mukuchin/SympleEncoderBoard/README.md

SympleEncoderBoard

エンコーダー用基板

神山先輩の回路をEagleで改良したもの

### dipスイッチについて

- 1～6番はエンコーダの回転向きの定義を切り替えるために使う。1～4番はエンコーダの1～4番の向きが切り替わる。5はX,6はY。

- 7は速度を出力するのか、積分したあとの位置を出力するかを切り替える。

- 8は2枚目のボードをつないだときに識別できるようにボード番号を切り替えるためのもの。
