mukuchin/SympleEncoderBoard/SympleEncoderBoard.brd

## EAGLE design SympleEncoderBoard.brd (2021-01-08)

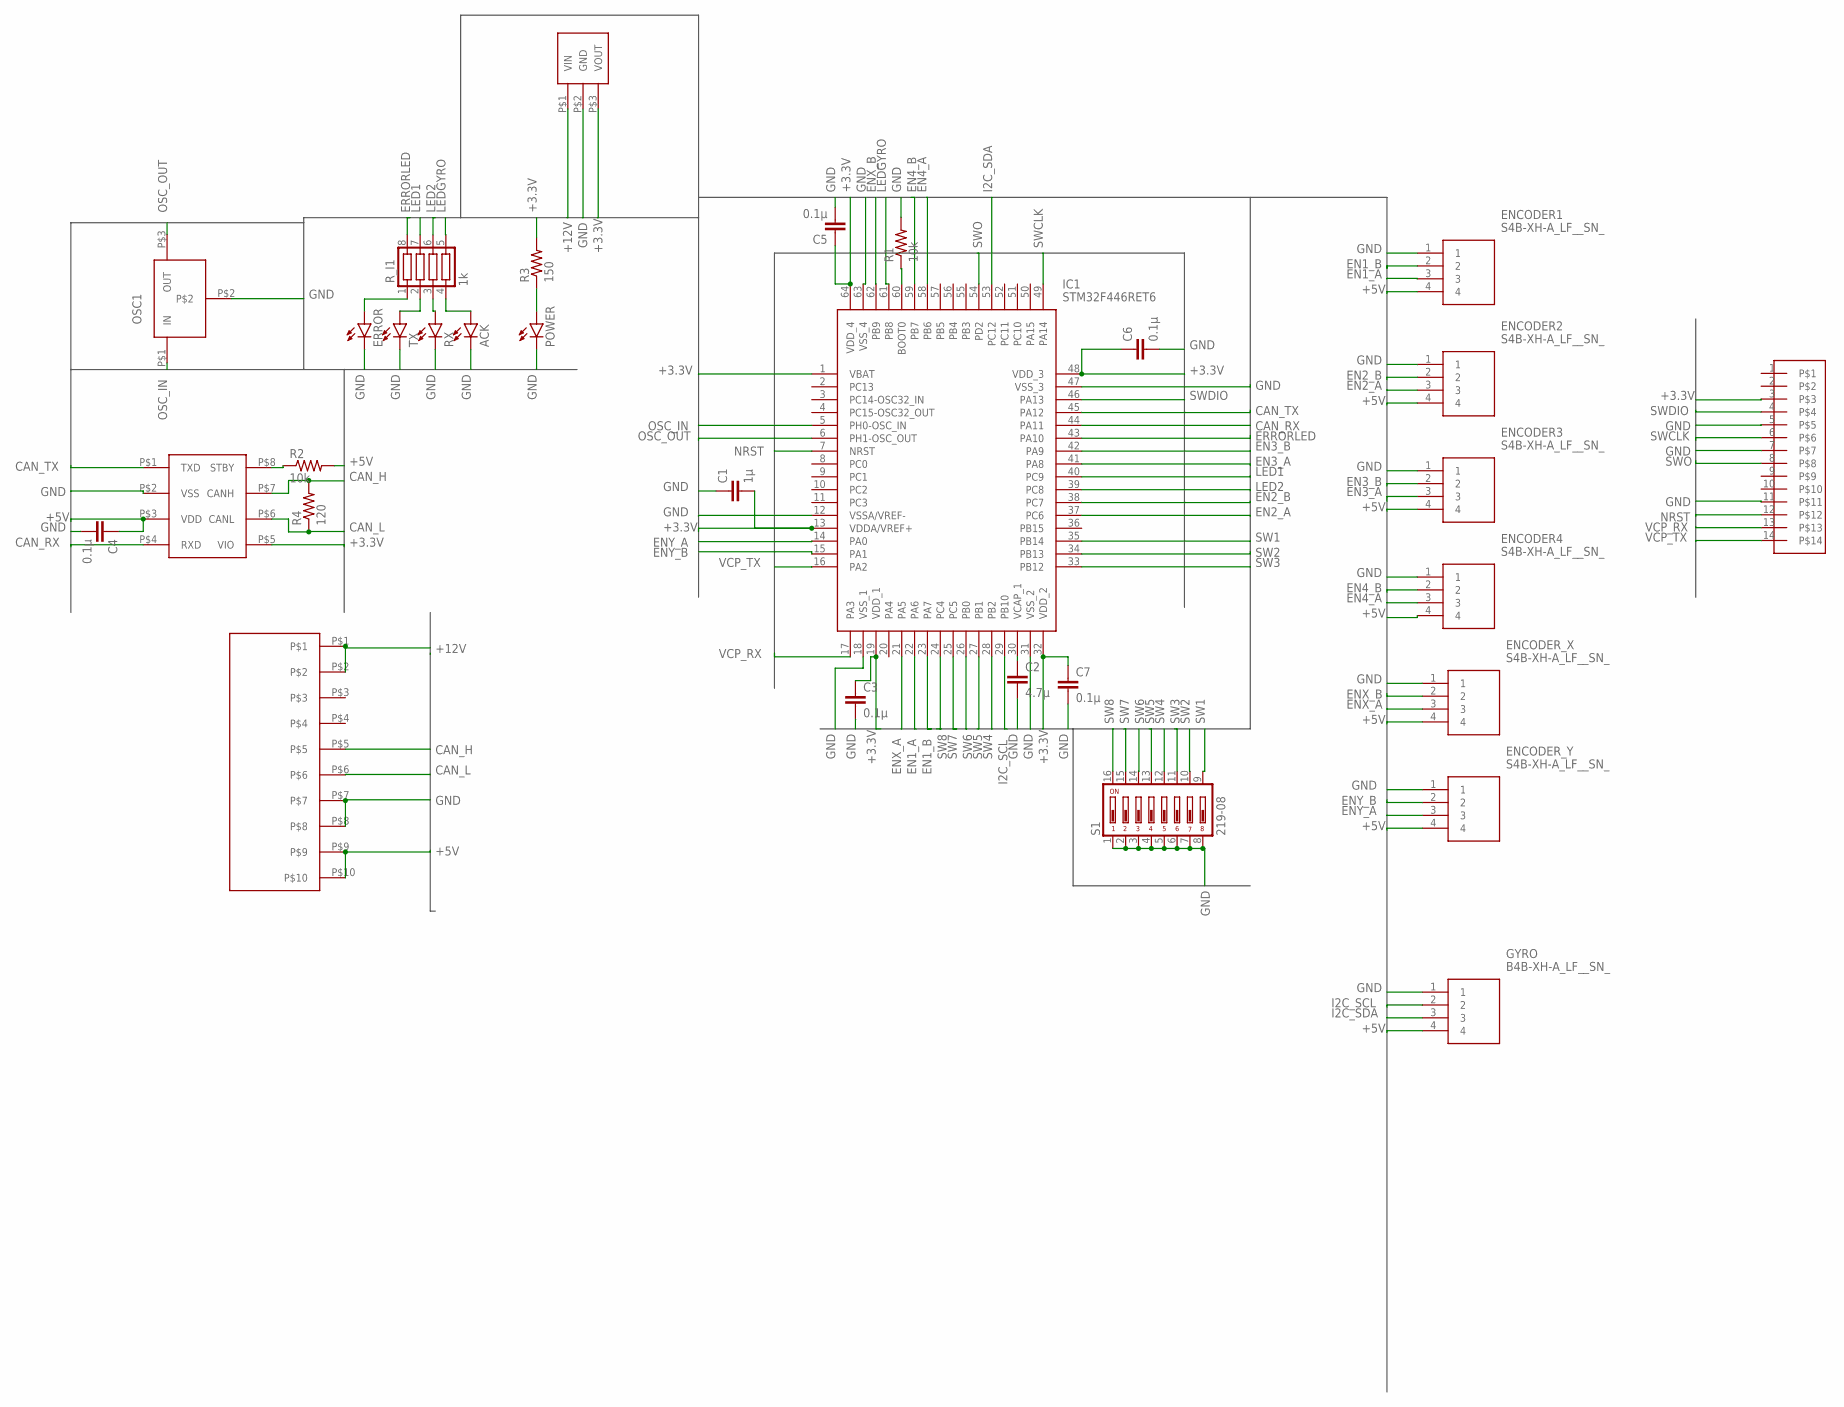
[picture p1: schematic SympleEncoderBoard.sch]

Parts:
ACK: LEDCHIPLED_0603; CHIPLED_0603
C1: 1μ; C1608
C2: 4.7μ; C0603
C3, C5, C6, C7: 0.1μ; C0603
C4: 0.1μ; C1608
ENCODER1, ENCODER2, ENCODER3, ENCODER4: S4B-XH-A_LF__SN_; SHDRRA4W64P0X250_1X4_1240X1150
ENCODER_X: S4B-XH-A_LF__SN_; SHDRRA4W64P0X250_1X4_1240X1150
ENCODER_Y: S4B-XH-A_LF__SN_; SHDRRA4W64P0X250_1X4_1240X1150
ERROR: LEDCHIPLED_0603; CHIPLED_0603
GYRO: B4B-XH-A_LF__SN_; SHDR4W64P0X250_1X4_1240X575X70
IC1: STM32F446RET6; QFP50P1200X1200X160-64N
OSC1: CSTN#; CSTNE#
POWER: LEDCHIPLED_0603; CHIPLED_0603
R1, R2: 10k; R0603
R3: 150; R0603
R4: 120; R0603
RX: LEDCHIPLED_0603; CHIPLED_0603
R_I1: 1k; 0603X4RESISTOR
S1: 219-08; CTS-219-08
TX: LEDCHIPLED_0603; CHIPLED_0603
U$1: BOX14P; CON_HEDA14P_1.27
U$2: BP5293-33; DC/DC_REGULATOR_3P
U$3: MCP2562MCP2561-SN; SOIC8
U$4: BOX10PBOX10P-L; BOX10P-L

Connections:
+3.3V: C1.2, C3.1, C5.1, C6.1, C7.1, IC1.1 (VBAT), IC1.13 (VDDA/VREF+), IC1.19 (VDD_1), IC1.32 (VDD_2), IC1.48 (VDD_3), IC1.64 (VDD_4), R3.2, U$1.3, U$2.P$3 (VOUT), U$3.P$5 (VIO)
+5V: C4.1, ENCODER1.4, ENCODER2.4, ENCODER3.4, ENCODER4.4, ENCODER_X.4, ENCODER_Y.4, GYRO.4, R2.2, U$3.P$3 (VDD), U$4.P$9, U$4.P$10
+12V: U$2.P$1 (VIN), U$4.P$1, U$4.P$2
CAN_H: R4.2, U$3.P$7 (CANH), U$4.P$5
CAN_L: R4.1, U$3.P$6 (CANL), U$4.P$6
CAN_RX: IC1.44 (PA11), U$3.P$4 (RXD)
CAN_TX: IC1.45 (PA12), U$3.P$1 (TXD)
EN1_A: ENCODER1.3, IC1.22 (PA6)
EN1_B: ENCODER1.2, IC1.23 (PA7)
EN2_A: ENCODER2.3, IC1.37 (PC6)
EN2_B: ENCODER2.2, IC1.38 (PC7)
EN3_A: ENCODER3.3, IC1.41 (PA8)
EN3_B: ENCODER3.2, IC1.42 (PA9)
EN4_A: ENCODER4.3, IC1.58 (PB6)
EN4_B: ENCODER4.2, IC1.59 (PB7)
ENX_A: ENCODER_X.3, IC1.21 (PA5)
ENX_B: ENCODER_X.2, IC1.62 (PB9)
ENY_A: ENCODER_Y.3, IC1.14 (PA0)
ENY_B: ENCODER_Y.2, IC1.15 (PA1)
ERRORLED: IC1.43 (PA10), R_I1.8
GND: ACK.C, C1.1, C2.2, C3.2, C4.2, C5.2, C6.2, C7.2, ENCODER1.1, ENCODER2.1, ENCODER3.1, ENCODER4.1, ENCODER_X.1, ENCODER_Y.1, ERROR.C, GYRO.1, IC1.12 (VSSA/VREF-), IC1.18 (VSS_1), IC1.31 (VSS_2), IC1.47 (VSS_3), IC1.63 (VSS_4), OSC1.P$2, POWER.C, R1.2, RX.C, S1.1, S1.2, S1.3, S1.4, S1.5, S1.6, S1.7, S1.8, TX.C, U$1.5, U$1.7, U$1.11, U$2.P$2 (GND), U$3.P$2 (VSS), U$4.P$7, U$4.P$8
I2C_SCL: GYRO.2, IC1.29 (PB10)
I2C_SDA: GYRO.3, IC1.53 (PC12)
LED1: IC1.40 (PC9), R_I1.7
LED2: IC1.39 (PC8), R_I1.6
LEDGYRO: IC1.61 (PB8), R_I1.5
unnamed: IC1.60 (BOOT0), R1.1
unnamed: C2.1, IC1.30 (VCAP_1)
unnamed: ERROR.A, R_I1.1
unnamed: R_I1.2, TX.A
unnamed: RX.A, R_I1.3
unnamed: ACK.A, R_I1.4
unnamed: R2.1, U$3.P$8 (STBY)
unnamed: POWER.A, R3.1
NRST: IC1.7 (NRST), U$1.12
OSC_IN: IC1.5 (PH0-OSC_IN), OSC1.P$1 (IN)
OSC_OUT: IC1.6 (PH1-OSC_OUT), OSC1.P$3 (OUT)
SW1: IC1.35 (PB14), S1.9
SW2: IC1.34 (PB13), S1.10
SW3: IC1.33 (PB12), S1.11
SW4: IC1.28 (PB2), S1.12
SW5: IC1.27 (PB1), S1.13
SW6: IC1.26 (PB0), S1.14
SW7: IC1.25 (PC5), S1.15
SW8: IC1.24 (PC4), S1.16
SWCLK: IC1.49 (PA14), U$1.6
SWDIO: IC1.46 (PA13), U$1.4
SWO: IC1.54 (PD2), U$1.8
VCP_RX: IC1.17 (PA3), U$1.13
VCP_TX: IC1.16 (PA2), U$1.14

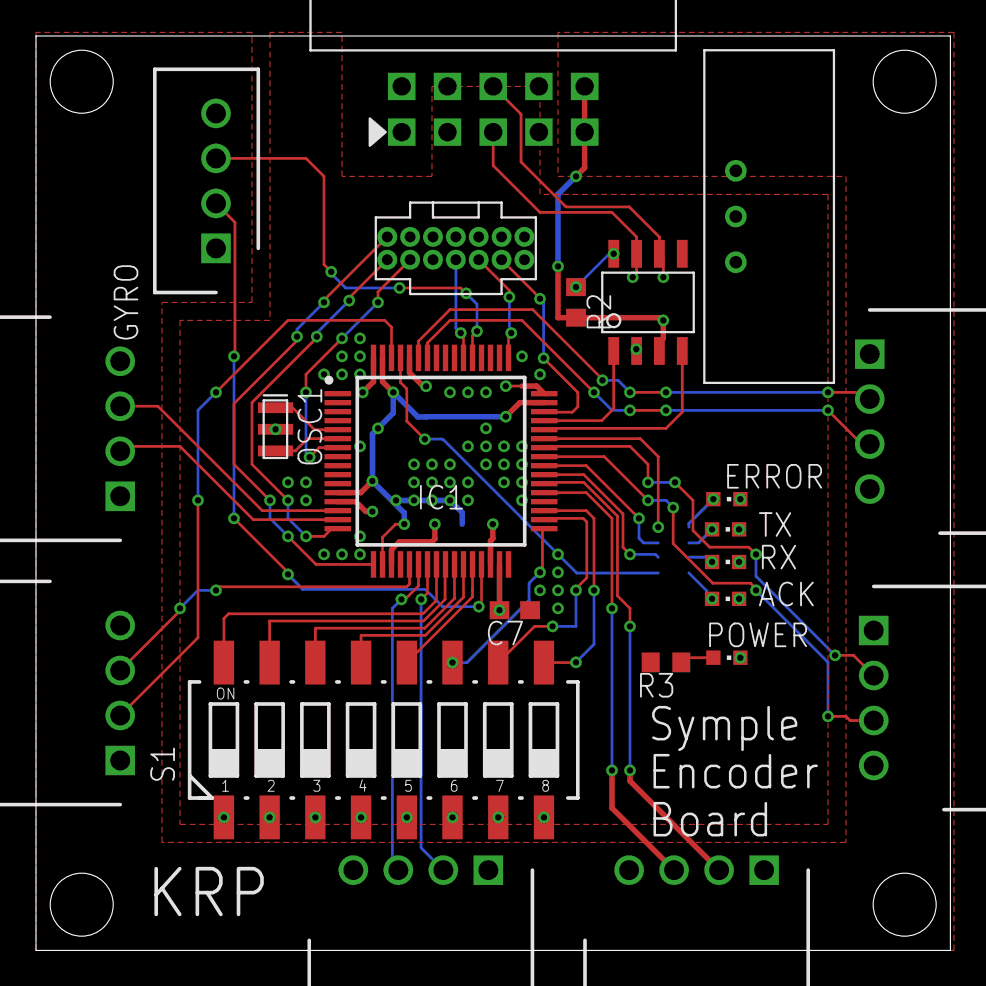
[picture p2: board SympleEncoderBoard.brd from above]

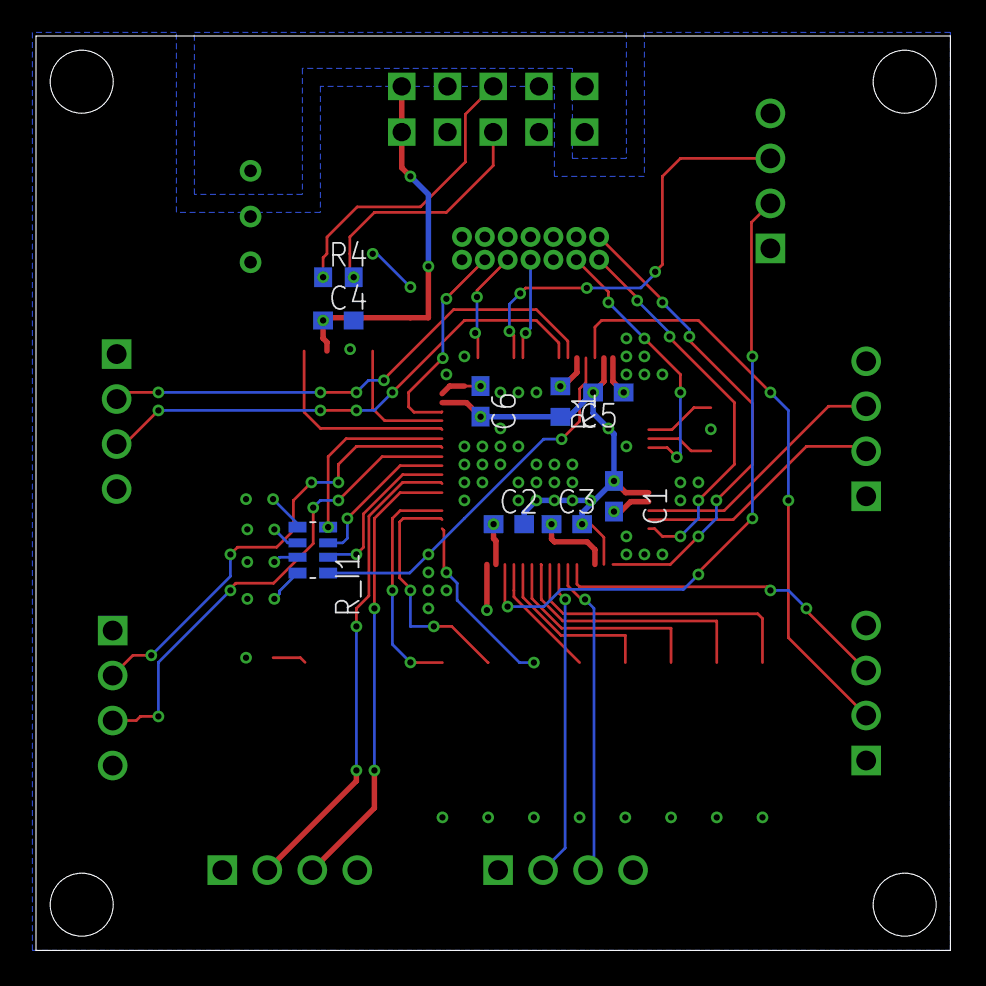
[picture p3: board SympleEncoderBoard.brd from below]

Board: 2 copper layers, 50.8 x 50.8 mm, 31 parts (9 on the bottom side), 50 nets.
