mukuchin/SympleEncoderBoard/(commit log)

2020-10-20 .sch加えた
    [SympleEncoderBoard.sch]
2020-10-20 無駄なもの消した
2020-10-20 コミットしたよ
2020-10-22 README.mdを加えたよ
2020-10-22 .schと.brd作ったよ
    [SympleEncoderBoard.brd, SympleEncoderBoard.sch]
2020-10-22 ライブラリとかバスを作った
    [SympleEncoderBoard.brd, SympleEncoderBoard.sch]
2020-10-22 ライブラリとかバスを作っただけ
    [SympleEncoderBoard.brd, SympleEncoderBoard.sch]
2020-10-28 回路図は完成、コネクタつけた
    [SympleEncoderBoard.brd, SympleEncoderBoard.sch]
2020-11-01 回路図書きました
    [SympleEncoderBoard.brd, SympleEncoderBoard.sch]
2020-11-01 10pboxのピンアサイン間違えてました
    [SympleEncoderBoard.brd, SympleEncoderBoard.sch]
2020-11-02 CANトランシーバの位置と型番更新、MLCC・VDD・VSS接続、配線太さ、14Pコネクタ配置変更
    [SympleEncoderBoard.brd, SympleEncoderBoard.sch]
2020-11-02 GYRO用XHコネクタを横から縦に、テキストの文字を少し拡大、ベタパターンDRCチェック済
    [SympleEncoderBoard.brd, SympleEncoderBoard.sch]
2020-11-02 GRYO用コネクタを横から縦に、テキストの文字を少し拡大、ベタパターンDRCチェック済、ガーバーデータ追加
2020-11-10 配線を何箇所か短くした
    [SympleEncoderBoard.brd]
2020-11-27 エラー等修正しました。
    [SympleEncoderBoard.brd, SympleEncoderBoard.csv, SympleEncoderBoard.sch]
2020-11-27 コネクタのホール修正しました
    [SympleEncoderBoard.brd, SympleEncoderBoard.sch]
2020-11-27 集合抵抗の値を変えました
    [SympleEncoderBoard.brd, SympleEncoderBoard.csv, SympleEncoderBoard.sch]
2020-12-02 SDAピンをPC11からPC12に修正した。
    [SympleEncoderBoard.brd, SympleEncoderBoard.sch]
2021-01-08 サーマルビアによる導通のエラーを直した
    [SympleEncoderBoard.brd]
2021-03-27 テキストファイルで部品表を作った
    [SympleEncoderBoard.csv]
